Drahflow/ParallelPrinter/doc/endstop-schematics.png

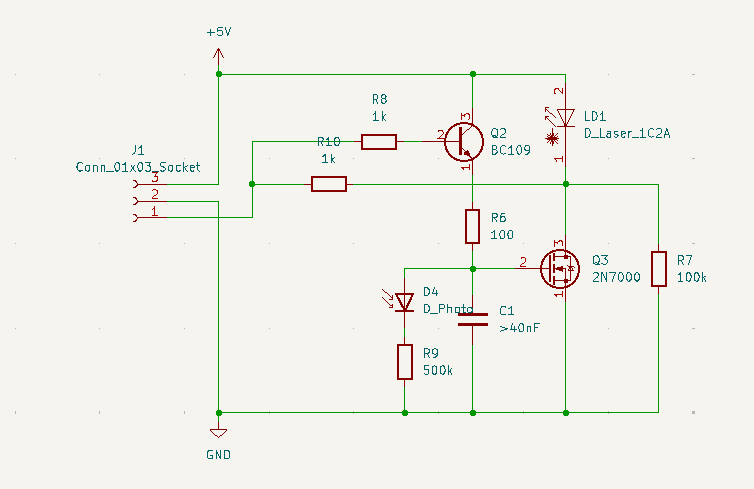
doc/endstop-schematics.png
