Drahflow/ParallelPrinter/FreeCad/Robot2.FCStd

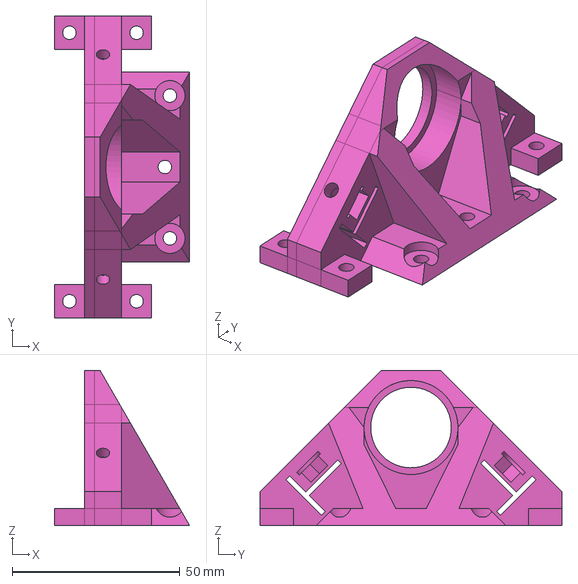
[picture p2: CAD file, 2023-06-02]
FreeCad/Robot2.FCStd
40.3 x 90.0 x 46.2 mm
