Drahflow/ParallelPrinter/FreeCad/Robot.FCStd

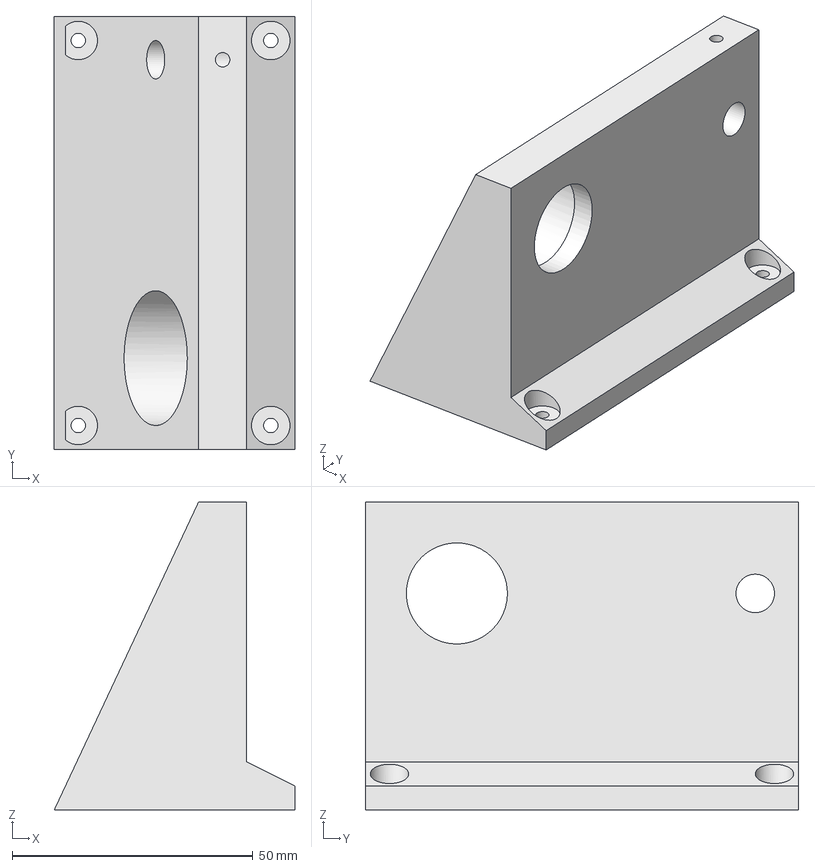
[picture p3: CAD file, 2023-05-03]
FreeCad/Robot.FCStd
50.0 x 90.0 x 64.0 mm
