Drahflow/ParallelPrinter/EndStopLight/endstoplight/endstoplight.kicad_sch

## KiCad design EndStopLight/endstoplight/endstoplight.kicad_sch (2023-12-01)

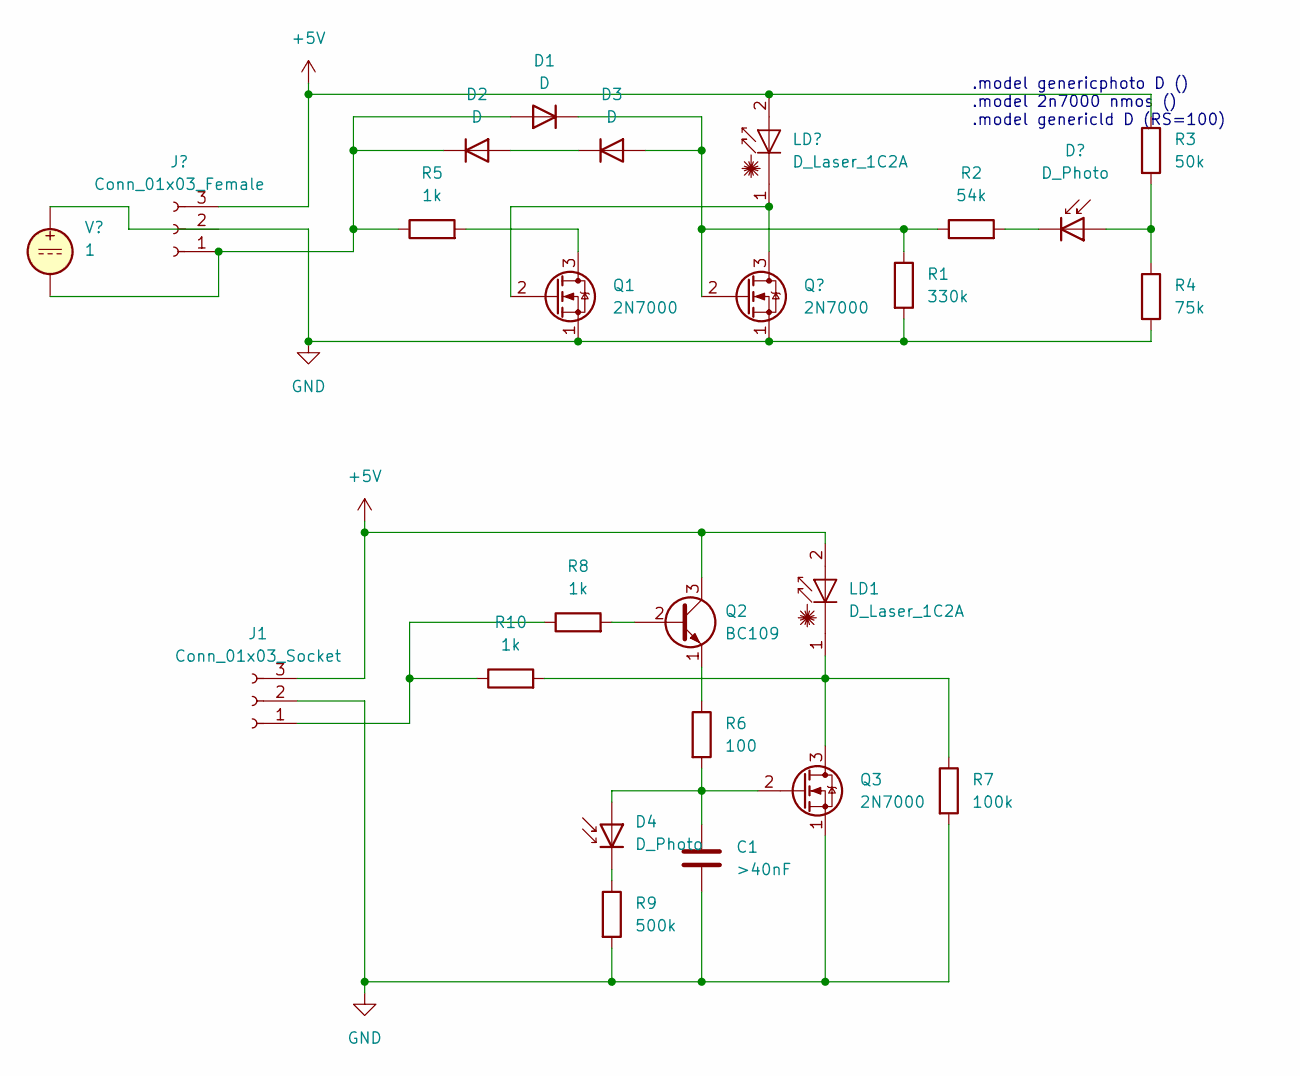
[picture p4: schematic endstoplight.kicad_sch]

Parts:
C1: >40nF
D1, D2, D3: D
D4: D_Photo
J1: Conn_01x03_Socket
LD1: D_Laser_1C2A
Q1, Q3: 2N7000; TO-92_Inline
Q2: BC109; TO-18-3
R1: 330k
R2: 54k
R3: 50k
R4: 75k
R5, R8, R10: 1k
R6: 100
R7: 100k
R9: 500k

Connections:
+5V: J1.3, LD1.2 (A), Q2.3 (C)
GND: C1.2, J1.2, Q3.1 (S), R7.2, R9.2
unnamed: C1.1, D4.2 (A), Q3.2 (G), R6.2
unnamed: D1.1 (K), D3.2 (A), R1.1, R2.1
unnamed: D1.2 (A), D2.1 (K), R5.1
unnamed: D2.2 (A), D3.1 (K)
unnamed: D4.1 (K), R9.1
unnamed: J1.1, R8.1, R10.1
unnamed: LD1.1 (K), Q3.3 (D), R7.1, R10.2
unnamed: Q1.1 (S), R1.2, R4.2
unnamed: Q1.3 (D), R5.2
unnamed: Q2.1 (E), R6.1
unnamed: Q2.2 (B), R8.2
unnamed: R3.2, R4.1

Notes on the sheet:
.model genericphoto D () .model 2n7000 nmos () .model genericld D (RS=100)
