Drahflow/ParallelPrinter/firmware/src/main.c

#include "usb.h"
#include "beep.h"
#include "watchdog.h"
#include "endstop.h"
#include "homing.h"
#include "kinematics.h"

int main() {
  // watchdog_init();
  initUSB();

  beep_synchronous(100, 880);
  uint32_t t = 0;

  while(1) {
    if(t++ == 10000000) {
      beep_synchronous(5, 880);
      t = 0;
    }

    runEndstop();
    runHoming();
    runKinematics();
    runUSB();
    watchdog_reset();
  }
}

void shutdown(char *error) { }
