Drahflow/ParallelPrinter/firmware/src/config.h

#ifndef H_BD023D83_2B94_4209_8045_AEF53C3D0CBD
#define H_BD023D83_2B94_4209_8045_AEF53C3D0CBD

#define CONFIG_USB_MANUFACTURER "Drahflow"
#define CONFIG_USB_PRODUCT "Parallel 3D"
#define CONFIG_USB_SERIAL_NUMBER "1"
#define CONFIG_USB_VENDOR_ID 0x1d50
#define CONFIG_USB_DEVICE_ID 0x614e
#define CONFIG_USB_SERIAL_NUMBER_CHIPID 1

#define CONFIG_FLASH_SIZE 0x40000
#define CONFIG_FLASH_BOOT_ADDRESS 0x8000000
#define CONFIG_RAM_START 0x20000000
#define CONFIG_RAM_SIZE 0x20000
#define CONFIG_STACK_SIZE 512
#define CONFIG_FLASH_APPLICATION_ADDRESS 0x8020000
#define CONFIG_STM32_DFU_ROM_ADDRESS 0x1ff09800
#define CONFIG_STM32_CLOCK_REF_INTERNAL 0
#define CONFIG_CLOCK_REF_FREQ 25000000

#define CONFIG_CLOCK_FREQ 400000000
#define CONFIG_TICK_FREQ     500000

// Signature to set in memory to flag that a dfu reboot is requested
#define USB_BOOT_FLAG 0x55534220424f4f54 // "USB BOOT"
#define USB_BOOT_FLAG_ADDR (0x24000000 + 0x8000) // Place flag in "AXI SRAM"

#define MOTOR_COUNT 10
#define MAIN_AXIS_COUNT 7

#endif
