Drahflow/ParallelPrinter/firmware/src/io.h

#ifndef __GENERIC_IO_H
#define __GENERIC_IO_H

#include <stdint.h> // uint32_t
#include "compiler.h" // barrier

static inline void writel(void *addr, uint32_t val) {
    barrier();
    *(volatile uint32_t *)addr = val;
}
static inline void writew(void *addr, uint16_t val) {
    barrier();
    *(volatile uint16_t *)addr = val;
}
static inline void writeb(void *addr, uint8_t val) {
    barrier();
    *(volatile uint8_t *)addr = val;
}
static inline uint32_t readl(const void *addr) {
    uint32_t val = *(volatile const uint32_t *)addr;
    barrier();
    return val;
}
static inline uint16_t readw(const void *addr) {
    uint16_t val = *(volatile const uint16_t *)addr;
    barrier();
    return val;
}
static inline uint8_t readb(const void *addr) {
    uint8_t val = *(volatile const uint8_t *)addr;
    barrier();
    return val;
}

typedef enum
{
  RESET = 0,
  SET = !RESET
} FlagStatus, ITStatus;

typedef enum
{
  DISABLE = 0,
  ENABLE = !DISABLE
} FunctionalState;
#define IS_FUNCTIONAL_STATE(STATE) (((STATE) == DISABLE) || ((STATE) == ENABLE))

typedef enum
{
  SUCCESS = 0,
  ERROR = !SUCCESS
} ErrorStatus;

#define SET_BIT(REG, BIT)     ((REG) |= (BIT))
#define CLEAR_BIT(REG, BIT)   ((REG) &= ~(BIT))
#define READ_BIT(REG, BIT)    ((REG) & (BIT))
#define CLEAR_REG(REG)        ((REG) = (0x0))
#define WRITE_REG(REG, VAL)   ((REG) = (VAL))
#define READ_REG(REG)         ((REG))
#define MODIFY_REG(REG, CLEARMASK, SETMASK)  WRITE_REG((REG), (((READ_REG(REG)) & (~(CLEARMASK))) | (SETMASK)))
#define POSITION_VAL(VAL)     (__CLZ(__RBIT(VAL)))

#define cpu_to_le16(x) ((uint16_t)(x))
#define cpu_to_le32(x) ((uint32_t)(x))
#define cpu_to_le64(x) ((uint64_t)(x))
#define le16_to_cpu(x) ((uint16_t)(x))
#define le32_to_cpu(x) ((uint32_t)(x))
#define le64_to_cpu(x) ((uint64_t)(x))

#define cpu_to_be16(x) __builtin_bswap16(x)
#define cpu_to_be32(x) __builtin_bswap32(x)
#define cpu_to_be64(x) __builtin_bswap64(x)
#define be16_to_cpu(x) __builtin_bswap16(x)
#define be32_to_cpu(x) __builtin_bswap32(x)
#define be64_to_cpu(x) __builtin_bswap64(x)

#endif // io.h
