Drahflow/ParallelPrinter/(commit log)

2023-04-12 Correctly restrain strut lengthwise rotation
    [printhead.c]
2023-04-19 Support initial motor position
2023-04-19 First setup which might flip
    [printhead.c]
2023-05-03 CAD Part Designs
    [Robot.FCStd]
2023-05-05 All Axle Parts
2023-05-05 Assembled and newly meched
2023-05-08 Actually printing
2023-05-08 Adjusted Axle Clearance
2023-05-13 Better Gimbal Design
    [Robot2.FCStd]
2023-05-13 More Clearance
    [Robot2.FCStd]
2023-05-22 Linear Slider
    [Robot2.FCStd]
2023-05-23 Slider working (and assembleable)
    [Robot2.FCStd]
2023-05-29 Allow using less support on Slider
    [Robot2.FCStd]
2023-05-30 Holders for Main Screw Nut
    [Robot2.FCStd]
2023-05-30 Rail fixtures
    [Robot2.FCStd]
2023-06-02 Changes after some prints
    [Robot2.FCStd]
2023-06-08 First axle assembled (for testing)
2023-06-08 (Manual) motor1 control \o/
2023-06-09 UART comms
2023-06-13 Stepper timing calculations
2023-06-23 Start of Digital Assembly
2023-06-25 Flags for triggering homing sensor
2023-06-26 Digital assembly of homing flags
2023-08-21 Wiring docs
2023-09-16 Before designing second platform back-connector
2023-10-28 Whoops, broke 3 mini-bearings and forgot 4 big ones
2023-11-05 Enabled all 7 axles
2023-12-01 Working laser beam endstop
    [endstoplight.kicad_pcb, endstoplight.kicad_sch]
2023-12-07 Working auto-homing
2023-12-07 Precision homing
2023-12-07 Adjust to neutral after endstop homing
2024-02-16 Last version with gear-style-lock
2024-02-28 New Slider initial assembly
2024-03-26 Updated endstop positions
2024-06-12 Stiffer X axis
2024-09-04 FEM-kinematics works with tests now
2024-09-19 Before endstop shortening
2024-09-23 Updated kinematics tests
2024-09-23 Calibration target on tablet
2024-10-07 Current firmware (includes step status)
2024-10-09 Screenshot of KiCad, just to be save
2024-11-29 KiCad version update
2024-11-29 Use atomics for interrupt i/o
2024-12-03 First testdrive with strengthened joints
    [console.c, console.h, kinematics.c, motor.h, tick.c]
2024-12-08 A plan for the calibration code
2024-12-20 Adding Microscope, Printer and Tablet device
2025-01-04 First time connecting to all devices required for calibration
2025-01-06 Stabilize and track focus measurements
2025-05-09 Side-Printed MainAxleFixture
2026-01-03 Non-CAD before 2026
